PauloIVM/custom-keyboard/components/keyboard-left/schematic.pdf

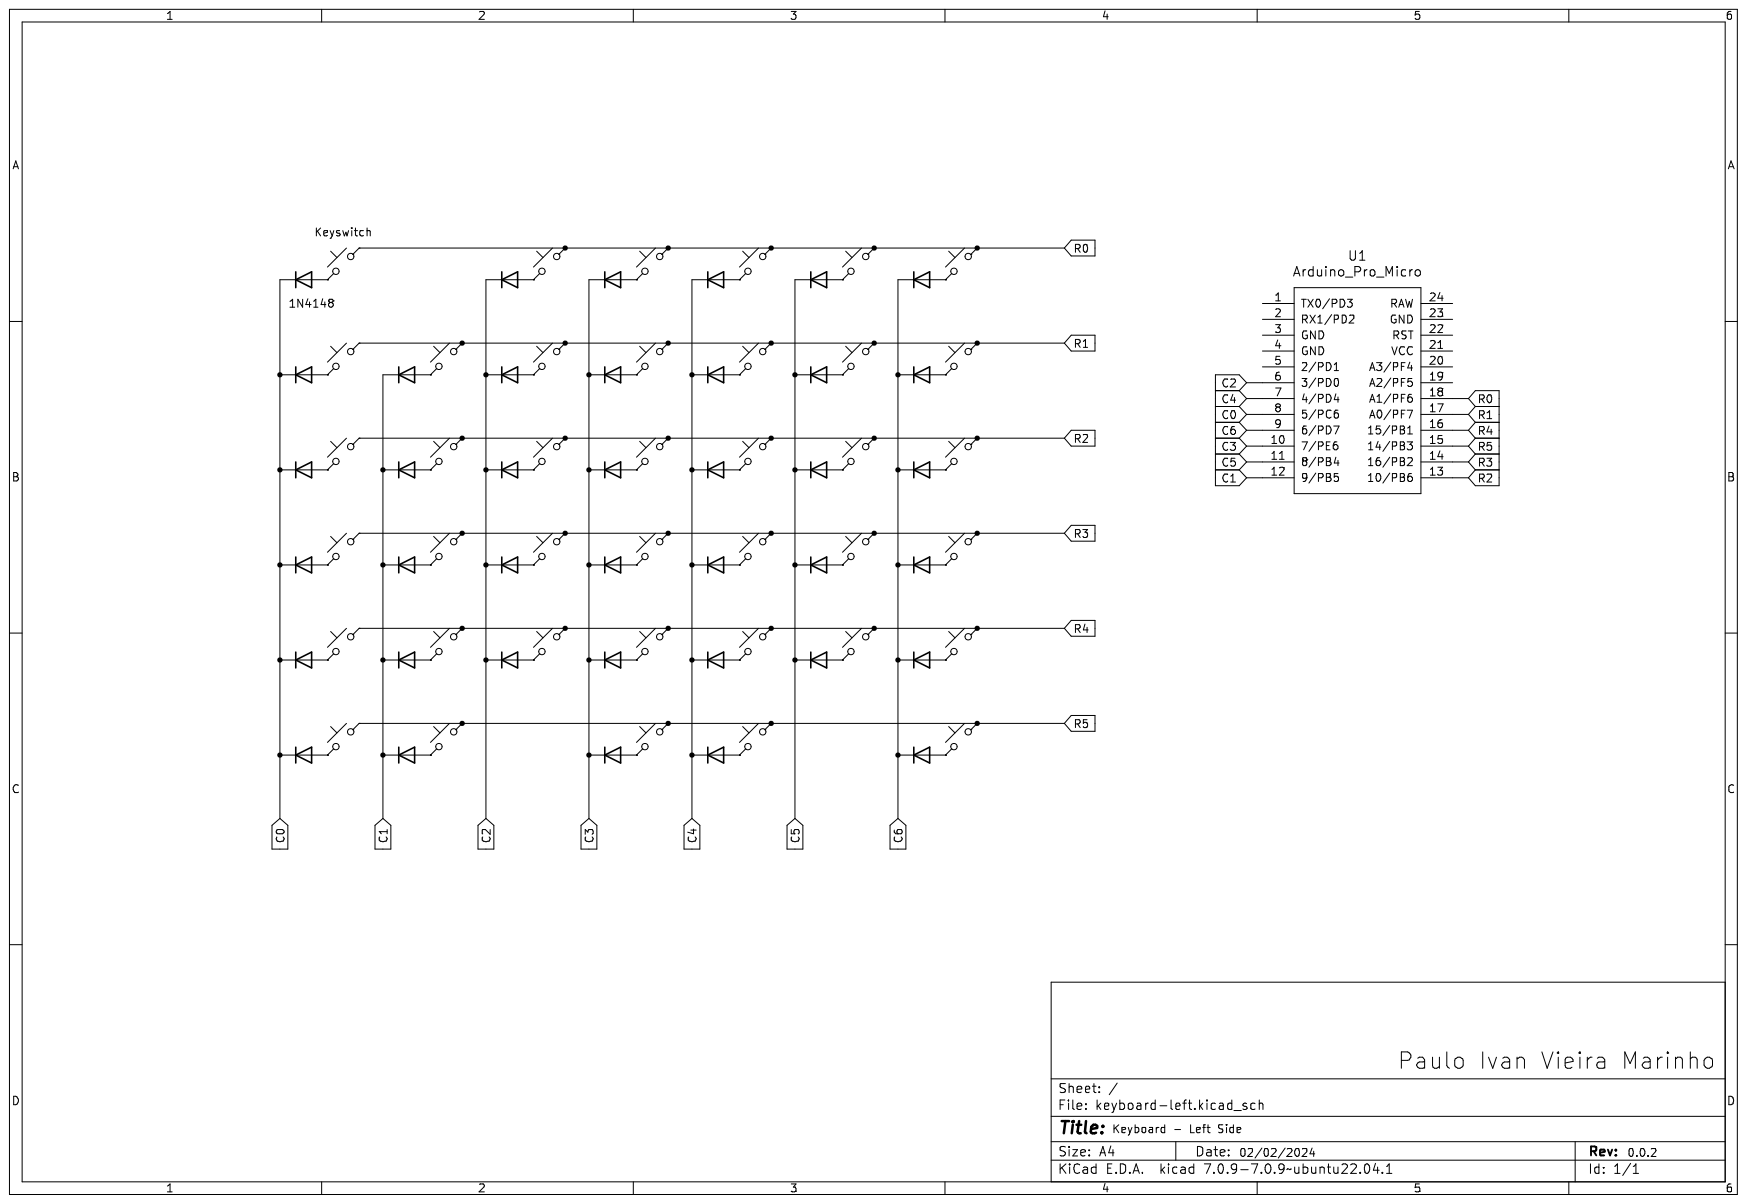
[picture p1: page 1]
