PauloIVM/custom-keyboard/components/keyboard-right/schematic.pdf

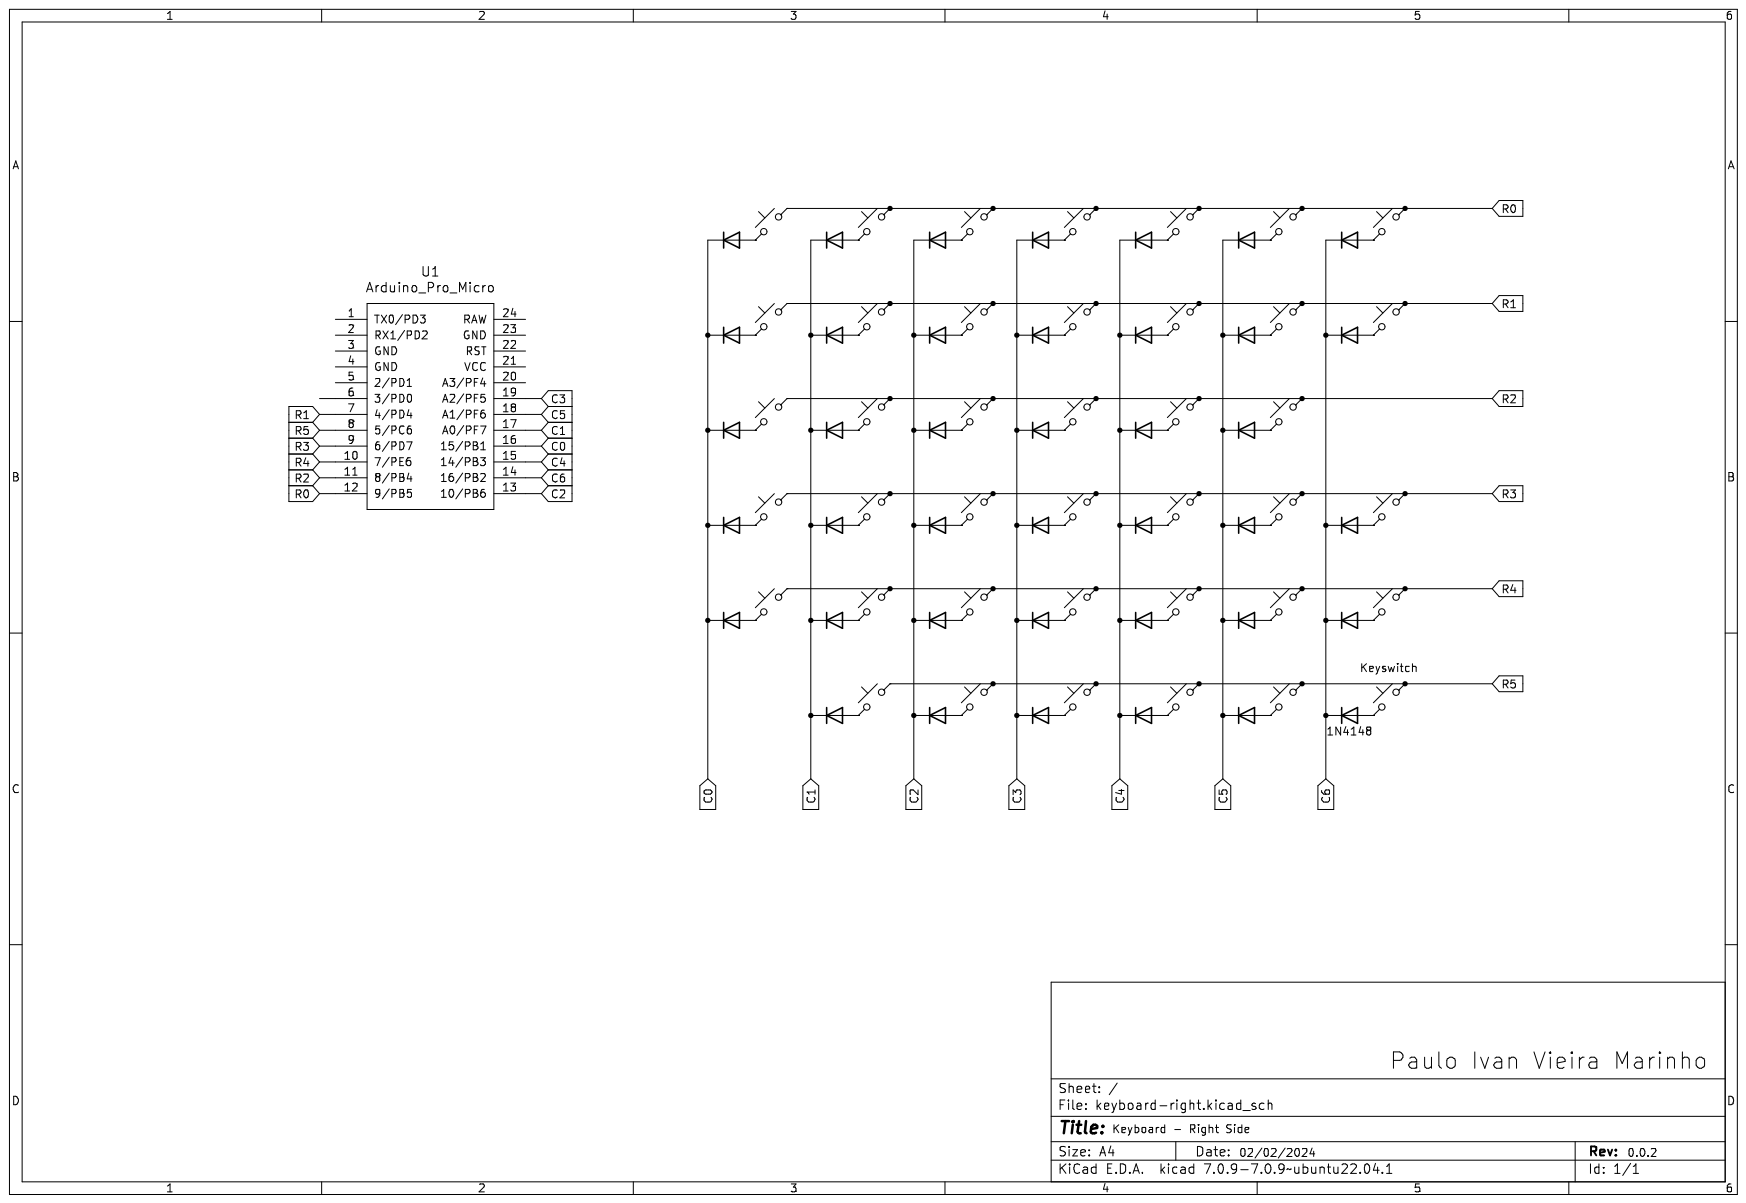
[picture p2: page 1]
