PauloIVM/custom-keyboard/components/mouse/schematic.pdf

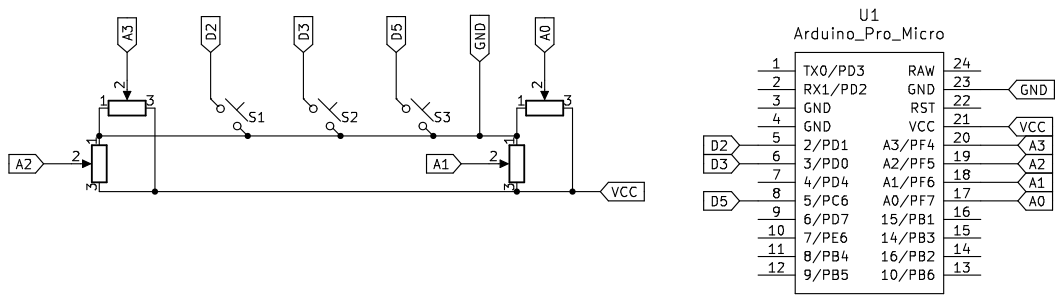
[picture p3: page 1]
