PauloIVM/custom-keyboard/(commit log)

2023-12-04 fix: change buttons order
    [mouse.ino]
2023-12-19 refactor(mouse): create button element
2024-01-31 chore(keyboard-left): config correct pins
    [keyboard-left.ino]
2024-02-02 chore: improve schematics
2024-02-02 chore: update schematics
